chandanmarkanda49/project_WEIGHT_MACHINE/(list of files, drawings)

Other design files:
PCB_PCB_WeightScaleByUNO_2_2025-10-18.json
PCB_PCB_WeightScaleByUNO_2_2025-10-29_added4_pushBUTTONS_and_2LEDs_for_Power_indication.json
